PA0LUX/Yaesu-FTdx-101-External-meters-and-tune-button/FTdx-101 meter display & Tune button schematic.jpg

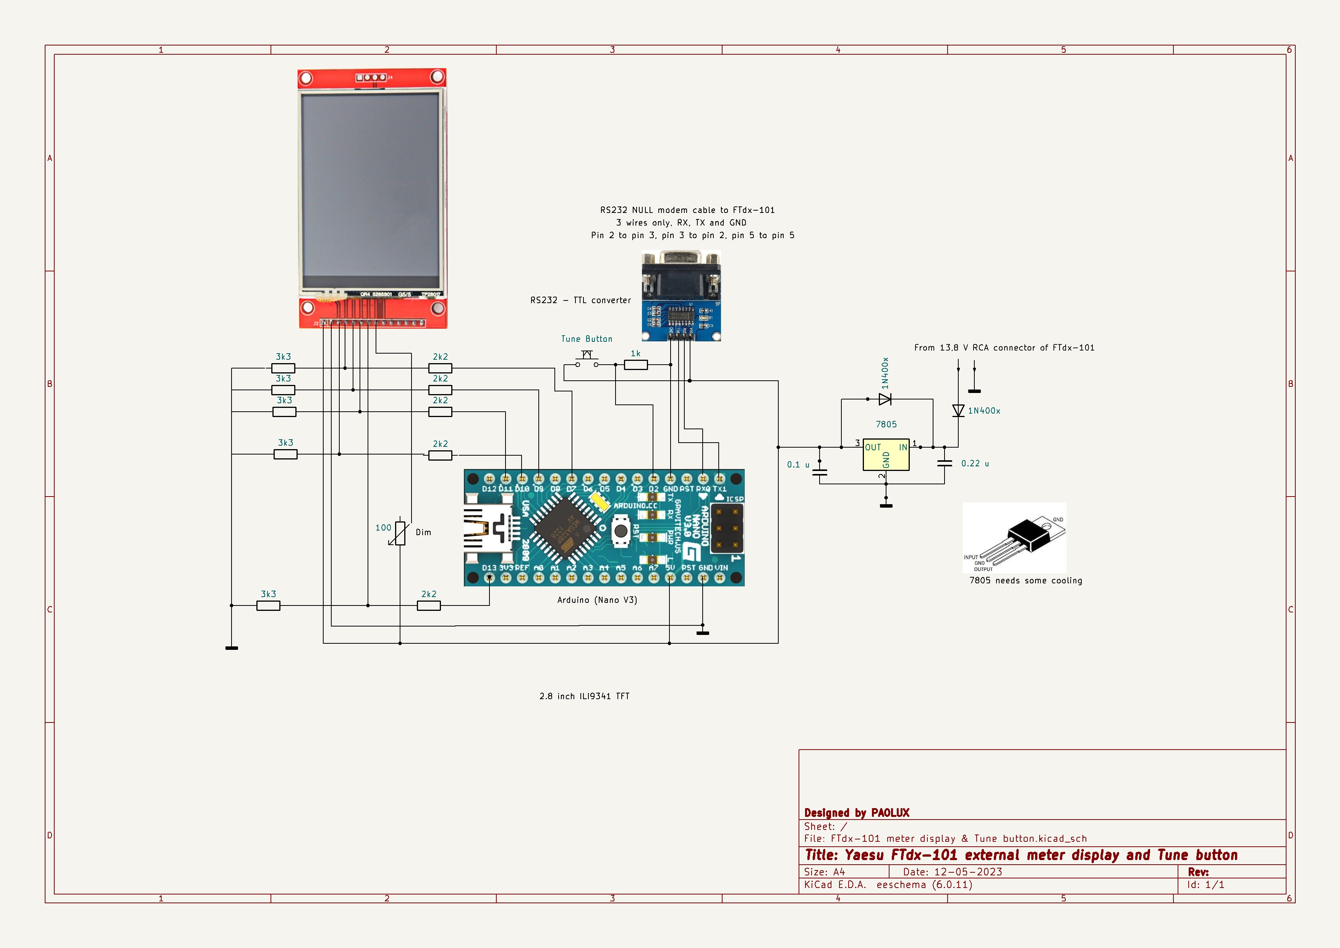
FTdx-101 meter display & Tune button schematic.jpg
