PA0LUX/Yaesu-FTdx-101-External-meters-and-tune-button/Yaesu FTdx-101 external meter display and Tune button.docx

Yaesu FTdx-101 external meter display and Tune button (By PA0LUX)

See also You Tube: https://youtu.be/S7MPvK0BMc8

30-11-2023: Note that the FUNC / OPERATING SETTINGS / TUNER SELECT has to be set to INT

(= default) in order to be able to use the Rs232 connection.

Note: There are 2 sketches in the download. One is named FTdx-101D....and the other is named FTdx101MP.... Be sure to use the correct file for your radio, otherwise some of the scales will be incorrect.

This is a design of an Arduino (Nano) with a 2.8“ TFT acting as a simultaneous (bargraph-)display of all 9 meters available in the FTdx-101. Also a 3.2 “TFT with the same resolution (240 x 320) and chip will work fine.

It reads all meter settings from the radio via CAT, through the Rs232 connector.

The display will also show what power has been set in the radio. Besides that, it has a (momentary) pushbutton that can be used to tune the radio with 20 Watts (adjustable in .ino file).

The following data are displayed:

- SWR

- Comp

- Temp

- IDD

- VDD

- ALC

- S Main - is substituted by Power out when in TX, S Main is set to OFF when receiver is off.

- S Sub - is set to OFF when receiver is off.

-Power out - instead of S Main, when in TX

- Present power setting

- Connection status

At tune button press, it stores the present power setting and the present mode. It will then engage an FM-N transmission.

When released, the tuning signal will stop. The present power setting is restored after the button has been released. The tune power can be adapted in the sketch with the variable; set_tune_pwr "PC020;" The 020 means 20W. You can change it to anything between 005 and 100.

The display shows a green “LED” to indicate that there is correct communication with the transceiver. The green led turns on when there is a correct answer received from the radio. It does check for correct baud rate. When not connected or when the transceiver is powered off (and 13,8 V still present), or a wrong baud rate, the green led will turn into a red one.

The circuit is to be connected to the RS232 connector of the transceiver (thru a null modem cable), thus leaving the USB connector of the transceiver available for other logging and/or CAT software. The Arduino cannot directly be connected to the transceiver. The FTdx-101 talks RS232 and the Arduino talks TTL levels. Therefore, a simple Rs232 – TTL level converter is used, widely available for about 2 euros. It comes complete with a 9 pin Rs232 D-connector.

It is advised to use a connector at least at one end for the connections between Arduino and Rs232 level converter.

Note; Do NOT connect USB and RS232 (of the Arduino) at the same time, it will not work (will do no harm either). Also, better not to connect 13,8V and USB at the same time.

To program the Arduino is very simple. Do not program while the Rs232 level converter is connected.

Make sure you have the Arduino IDE (downloaded and-) installed on your PC. This is the editor for sketches. Connect your Arduino via USB to the PC and check which new port has just shown up in your computer. Now in the Arduino IDE choose via “Tools” menu this port and choose the correct Arduino board (in my case Nano).

The program uses 4 libraries: Smoothed, SPI, Adafruit_GFX_Library-1.11.5 and Adafruit_ILI9341-1.5.12. Make sure you add these to your library (if not already present) using the Arduino IDE.

Copy the correct sketch (. ino file) to your PC and create a folder with exactly the same name as the copied file. Now move the copied file into the new folder.

Now in the Arduino IDE go to “Files” menu, choose open and navigate to the .ino file and open it.

Press the “right arrow” in the IDE. The program will be uploaded to the Arduino. It will indicate when ready.

Set the Rs232C rate in the FTdx101 to 19200 bd (menu: operation setting). Connect the cables and everything should work now.

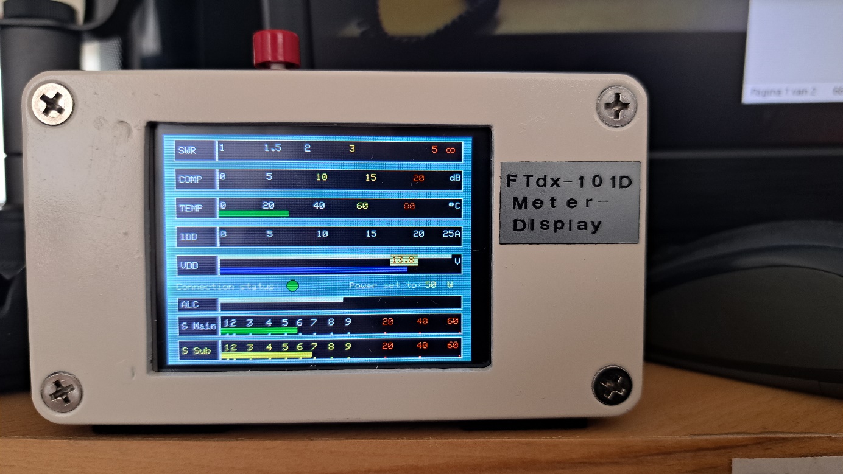
[picture p2: figure]
